isaac-adas/arduino-maze-solving-striker/README.md

<p align="center">

# STRIKER v3










**Wall-following maze robot for Arduino Uno.**

STRIKER holds one wall, takes the turn, and rolls out of the maze on its own. Three ultrasonic sensors, an L298N, and a tab-and-slot plate made for this robot. The plate is **15 × 10 cm**, about half the area of a common 21 × 15 cm chassis. The covers push into the body. Zip ties hold the battery and the driver. No screws and no glue.

<a href="https://youtu.be/cDdMQnneDAg">
  Watch STRIKER solve the maze
</a>

<br>



<br>

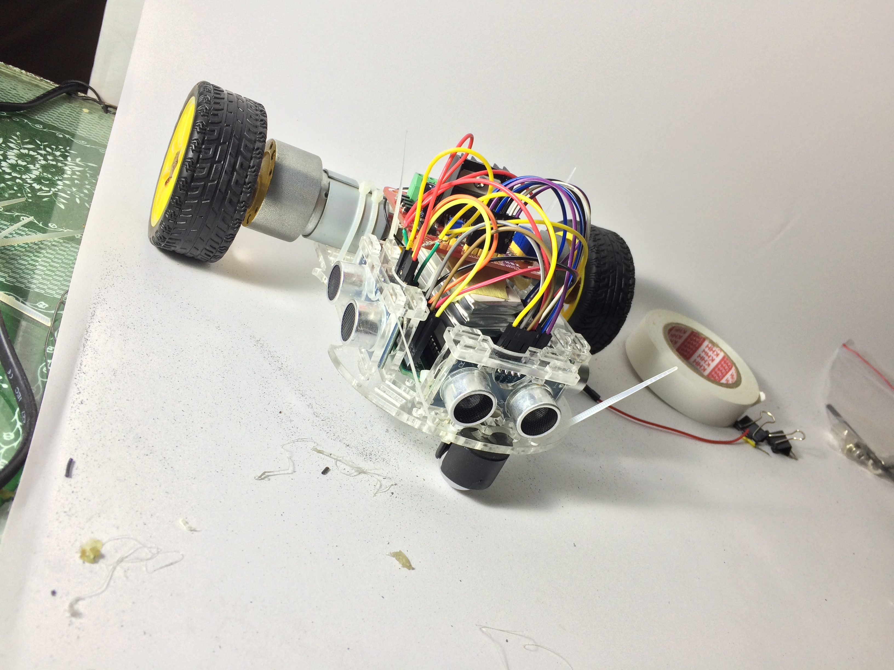
[picture p1: images/finished-robot.jpg]
STRIKER, finished


<br><br>

Build notes: [Maze Solving Robot on Instructables](https://www.instructables.com/Maze-Solving-Robot-MicroMouse-Wall-Following-Robot/)

<br>

[Sketch](#the-sketch) · [Try the wires](#try-the-wires-first) · [Parts](#parts) · [Wiring](#wiring) · [Start](#getting-started) · [Control panel](#control-panel) · [Chassis](#chassis) · [Repo](#repo)

</p>

---

## Repo

```
arduino-maze-solving-striker/
├── Striker_v3/Striker_v3.ino          maze sketch
├── SensorCheck/SensorCheck.ino        distances only, motors off
├── MotorDirection/MotorDirection.ino  one wheel, then the other
├── design/
│   ├── Striker_v3_Chassis.dxf         laser cut, no dimension lines
│   ├── Striker_v3_Chassis.pdf         same cut, for the shop
│   └── Striker_v3_Measures.pdf        dimensions, for reading
├── images/                            photos and the build drawings
├── docs/PIN_LAYOUT.md
├── libraries/NewPing/                 ultrasonic library
├── LICENSE
└── README.md
```

---

## The sketch

One file: [`Striker_v3/Striker_v3.ino`](Striker_v3/Striker_v3.ino).

Set `navigation` in the control panel:

| `navigation` | Steering |
|---|---|
| `SIMPLE_STEER` | Corrects in proportion to the distance error |
| `PID_STEER` | Proportional, integral, and derivative correction |

The sketch ships on `PID_STEER`. Switch to `SIMPLE_STEER` if you want one correction from `steerStrength` instead. Same wires either way.

Every setting you should change is in the **control panel** at the top of the sketch.

---

## Try the wires first

Upload one of these before the maze sketch. Same pins. Wheels off the ground for the motor test.

| Sketch | What you should see |
|---|---|
| [`SensorCheck`](SensorCheck/SensorCheck.ino) | Left, front, and right distances on the Serial Monitor at 115200. Motors stay off. |
| [`MotorDirection`](MotorDirection/MotorDirection.ino) | Left wheel, then right wheel, then both, each for one second. If a wheel goes backward, swap that motor's two wires. Upload nothing after the swap. |

---

## Parts

| Piece | Qty | Notes |
|---|---:|---|
| Arduino UNO | 1 | The brain |
| L298N motor driver | 1 | Wire ENA and ENB. Pull those jumpers only if a motor stays at full speed |
| HC-SR04 ultrasonic sensor | 3 | Left, front, right |
| DC motors + wheels | 2 | |
| 12V battery pack | 1 | Powers the motors through the L298N |
| LEDs + 220–330 Ω resistors | 3 | Optional status lights |
| Chassis, jumpers, zip ties | | See [design/](design/) |

---

## Wiring

The sensors use the analog pins as digital pins, so the PWM pins stay free for the motors.

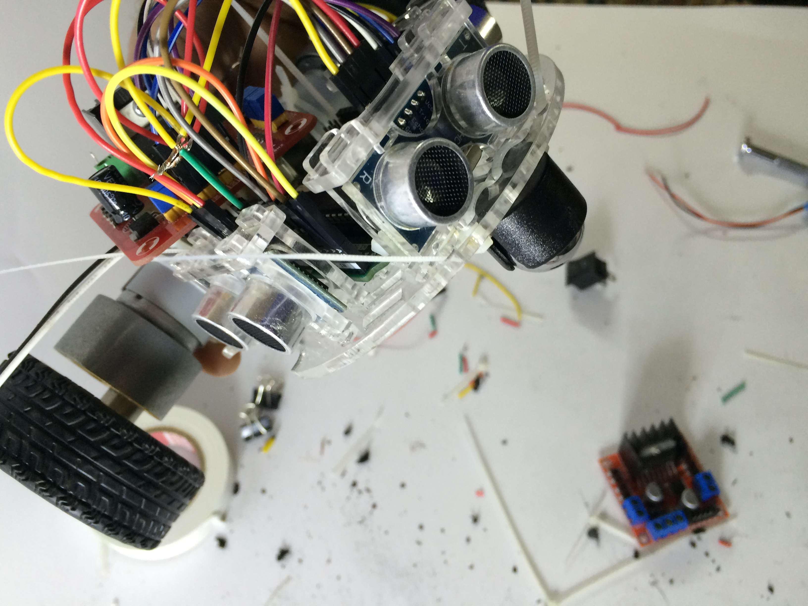
[picture p2: images/sensors-front.jpg]
Sensors on the front edge


```
                 FRONT
        [ L ]    [ F ]    [ R ]
 TRIG     A3       A4       A5
 ECHO     A0       A1       A2
```

| Sensor | TRIG | ECHO |
|---|---|---|
| Left | A3 | A0 |
| Front | A4 | A1 |
| Right | A5 | A2 |

All three sensors: **VCC → 5V**, **GND → GND**.

| L298N | Arduino | Job |
|---|---|---|
| IN1 | D4 | Right motor direction |
| IN2 | D5 | Right motor direction |
| IN3 | D2 | Left motor direction |
| IN4 | D3 | Left motor direction |
| ENA | D11 | Right speed (PWM) |
| ENB | D10 | Left speed (PWM) |

| LED | Pin |
|---|---|
| Status | D13 |
| Following left | D8 |
| Following right | D9 |

> **Power.** Motor current comes from the battery through the L298N, never from an Arduino pin. Tie the Arduino, L298N, sensor, and battery grounds together.

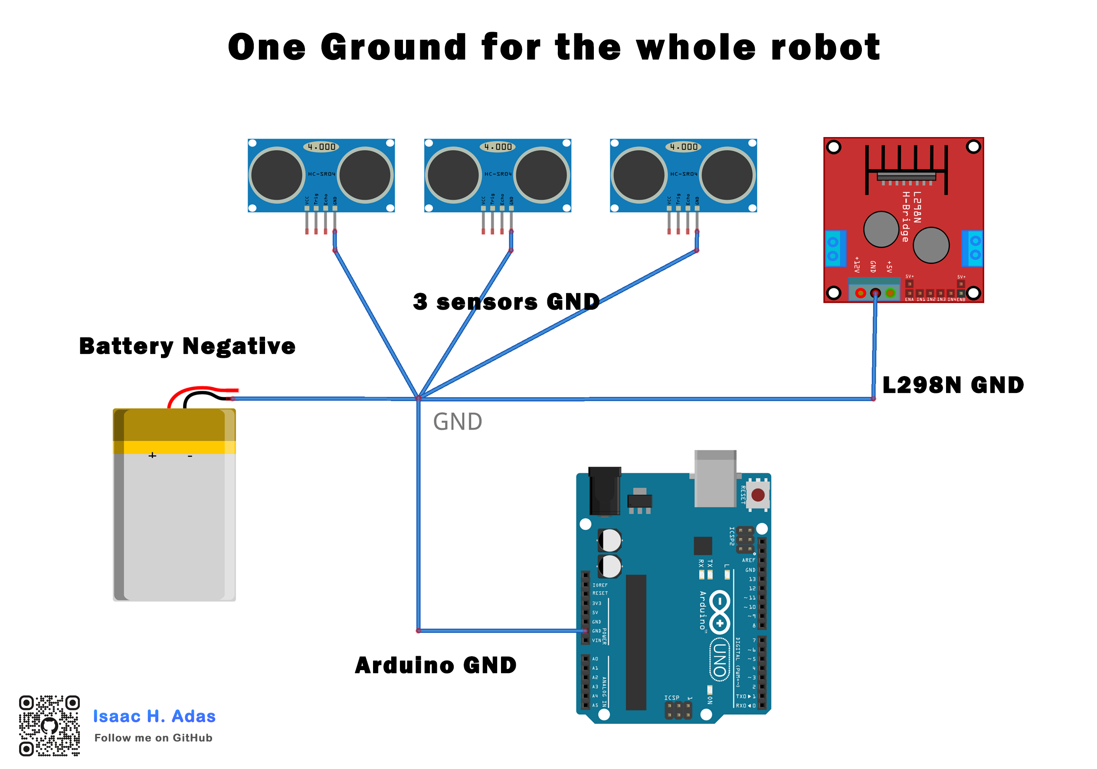
[picture p3: images/common-ground.png]
One ground for the whole robot


Full pin map: [`docs/PIN_LAYOUT.md`](docs/PIN_LAYOUT.md).

---

## Getting started

1. Install the [Arduino IDE](https://www.arduino.cc/en/software).
2. Install **NewPing**. A copy is in [`libraries/NewPing`](libraries/NewPing), or use the IDE Library Manager.
3. Open `Striker_v3`.
4. In the control panel, set `strategy` to `FOLLOW_AUTO`, `FOLLOW_LEFT`, or `FOLLOW_RIGHT`.
5. Leave `runCalibration` set to `false`.
6. Upload, open the Serial Monitor at **115200**, and set the robot in the maze.

Start slow. Raise the speed once it tracks the wall cleanly.

---

## Control panel

Change these at the top of the sketch. The rest of the file is the program.

### Which wall

| Set `strategy` to | What the robot does |
|---|---|
| `FOLLOW_AUTO` | Picks a wall at the first front wall |
| `FOLLOW_LEFT` | Always follows the left wall |
| `FOLLOW_RIGHT` | Always follows the right wall |

On `FOLLOW_AUTO`, the first opening decides. An opening on the left means follow the left wall. An opening on the right means follow the right wall. `autoDefault` is only for `FOLLOW_AUTO`, when both sides are open or both are blocked.

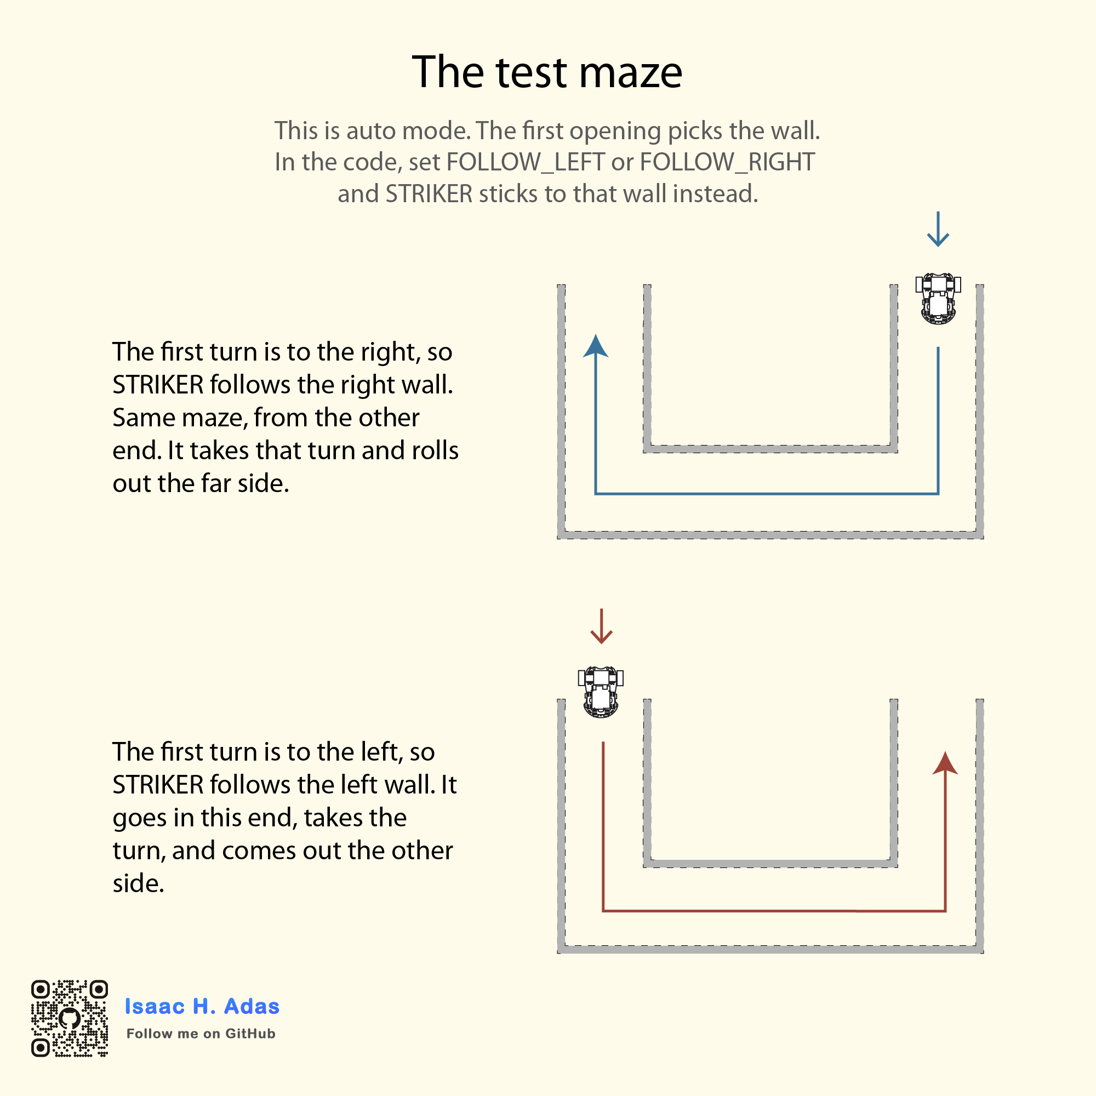
[picture p4: images/test-maze.png]
The test maze


### Passage width

`corridorWidthCm` is one corridor, measured from the left wall to the right wall.

A **30 cm** passage keeps the original distances:

| | Side wall | Front stop | Follow gap |
|---|---:|---:|---:|
| `SIMPLE_STEER` | 13 cm | 8 cm | 10 cm |
| `PID_STEER` | 13 cm | 7 cm | 10 cm |

Change `corridorWidthCm` and those three distances scale with it.

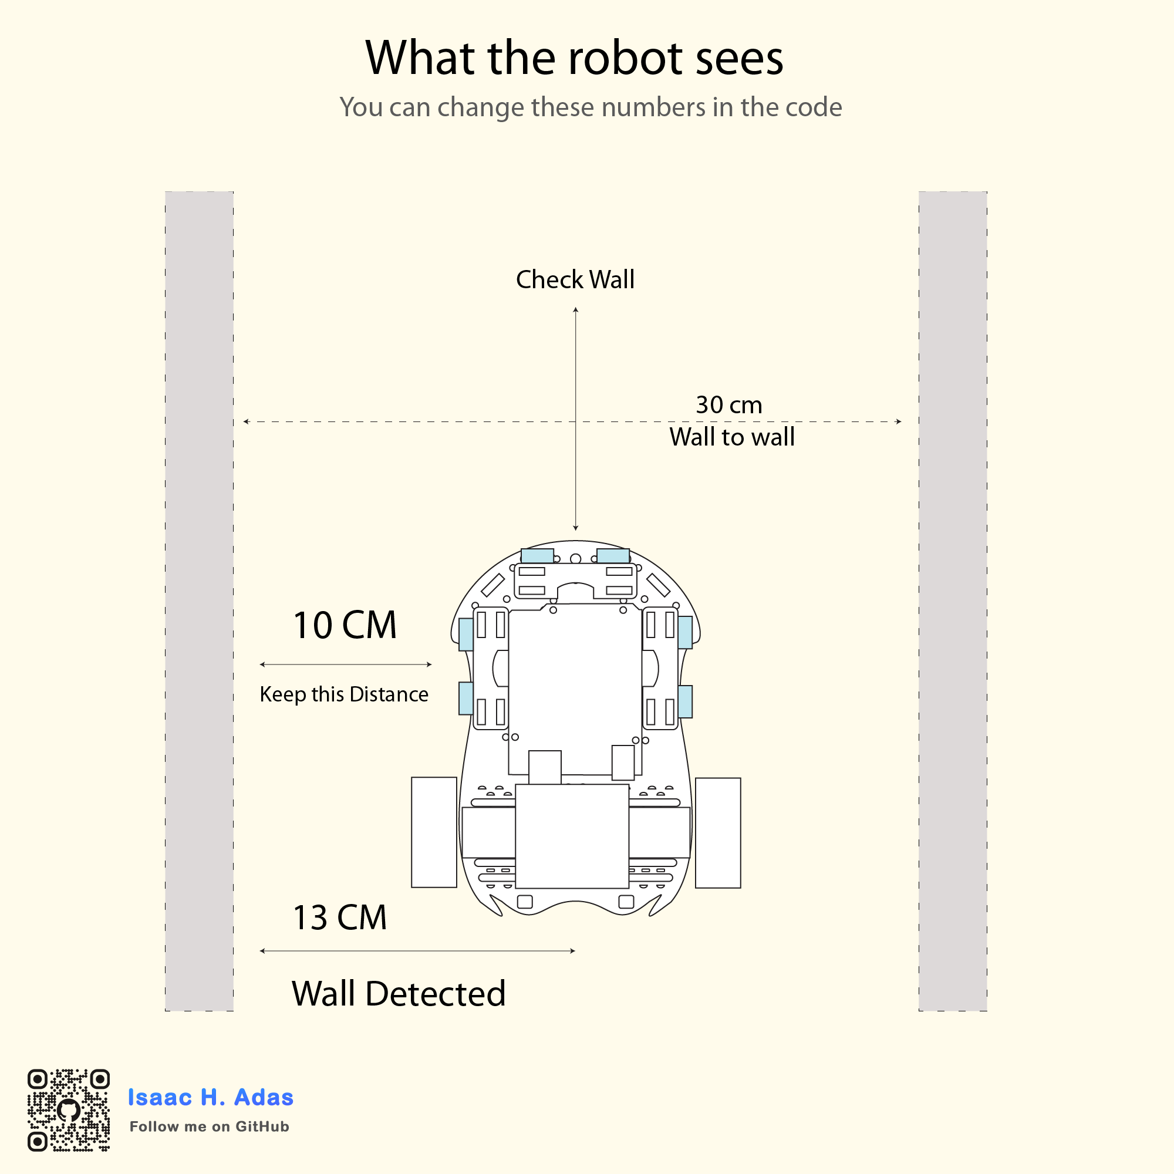
[picture p5: images/what-the-robot-sees.png]
What the robot sees


### Try other distances

1. Set `manualDistances` to `true`.
2. Edit `manualSideWallCm`, `manualFrontStopCm`, and `manualFollowCm`.

### Calibrate

Set `runCalibration` to `true`. The motors stay off.

Open the Serial Monitor at **115200**, put the robot in a passage facing along it, and it will:

1. Collect readings for `calibrationSeconds` (5 by default).
2. Print min, average, and max for each sensor.
3. Print the air gap between the side sensors, and say if that is wider than `corridorWidthCm`.
4. Print three numbers you can copy into the manual distance settings.
5. Keep printing live readings, marked `WALL` or `open`, so you can move the robot and see what the current distances do.

Set `runCalibration` back to `false` before a real run.

### Also in the panel

| Setting | What it changes |
|---|---|
| Speed | How fast it drives and turns |
| `navigation` | `SIMPLE_STEER` or `PID_STEER` |
| `steerStrength` | `SIMPLE_STEER`. How hard it corrects |
| `PID_KP`, `PID_KI`, `PID_KD` | `PID_STEER`. How hard it corrects |

Once the walls end, the robot stops so it does not drive off the stage.

---

## Chassis

The plate is **15 × 10 cm**, in **3 mm** acrylic, laid out on a common **30 × 50 cm** sheet. The cut uses **177 mm** of the 500 mm side. That is **35.4%** of the sheet. The other **323 mm**, **64.6%**, is left for the rest of your cuts. A common 2WD chassis is 21 × 15 cm, which is 315 cm². This plate is 150 cm², about half that area. A 135 × 135 mm plate is 182 cm², and this one is about 18% smaller. The same drawing cuts in plywood. Cardboard works too, and a little glue is fine on cardboard. The slots are sized for a 3 mm sheet. Files and build notes are in [`design/`](design/).

The outline is curved. The earlier plates had sharp edges, and a sharp edge can cut a hand. This one is safer and easier to handle. The file has more than one cover and more than one way to stack the parts. Use the spot where the part fits. The shop file is [`Striker_v3_Chassis.dxf`](design/Striker_v3_Chassis.dxf), and the same cut is [`Striker_v3_Chassis.pdf`](design/Striker_v3_Chassis.pdf). Dimensions are on [`Striker_v3_Measures.pdf`](design/Striker_v3_Measures.pdf). The part on the right of the drawing is the robot. Cut that. The part on the left is optional: the upper deck, the name, and the other pieces on that side.

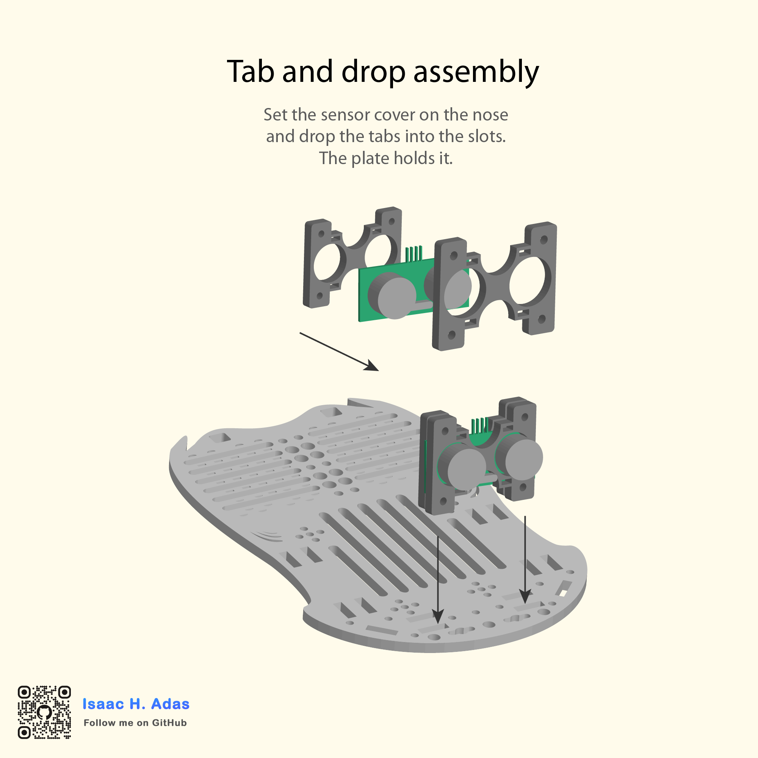
[picture p6: images/tab-and-drop.png]
Tab and drop assembly


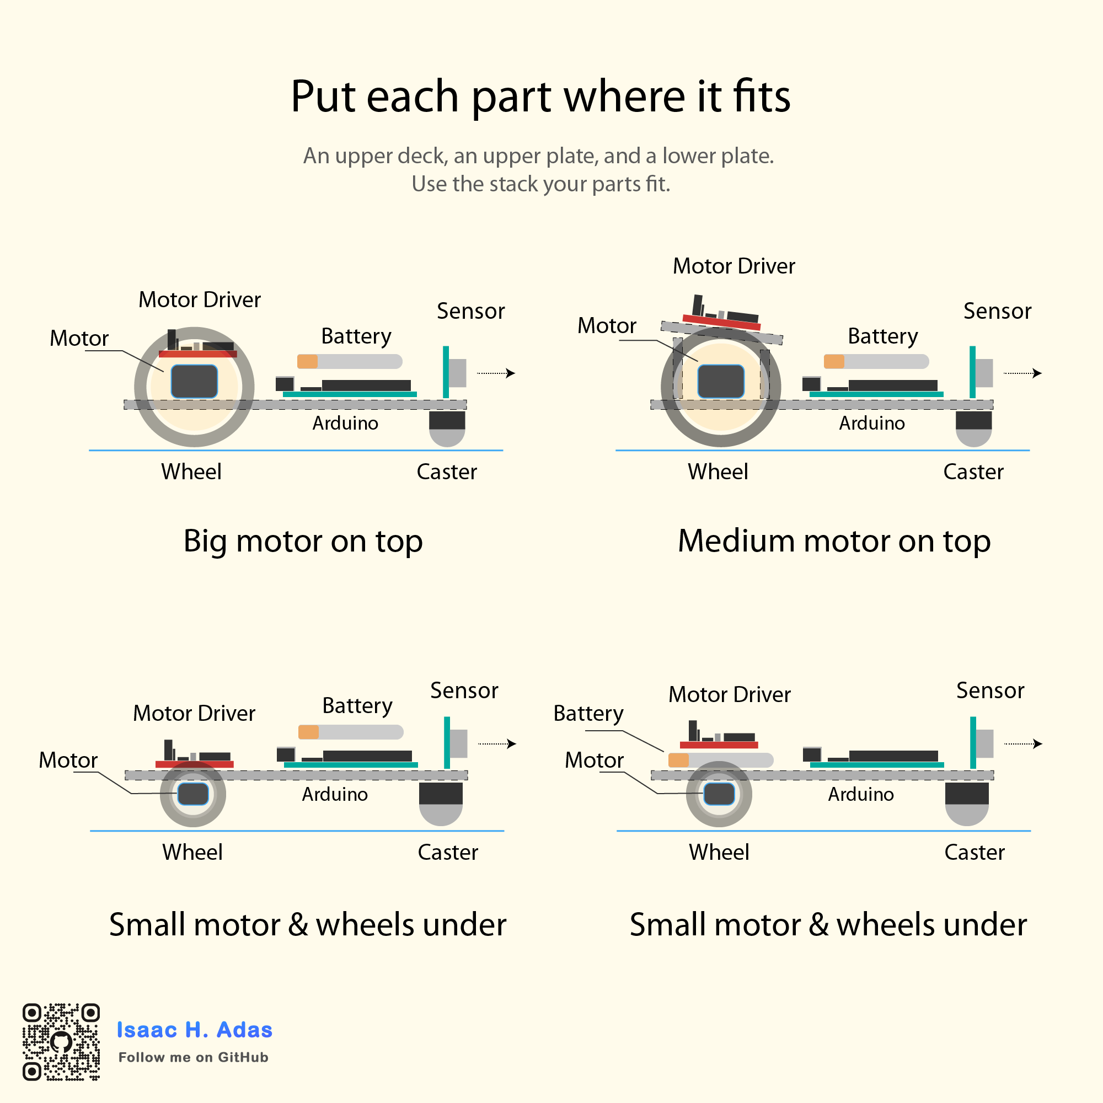
[picture p7: images/parts-fit.png]
Where the parts fit


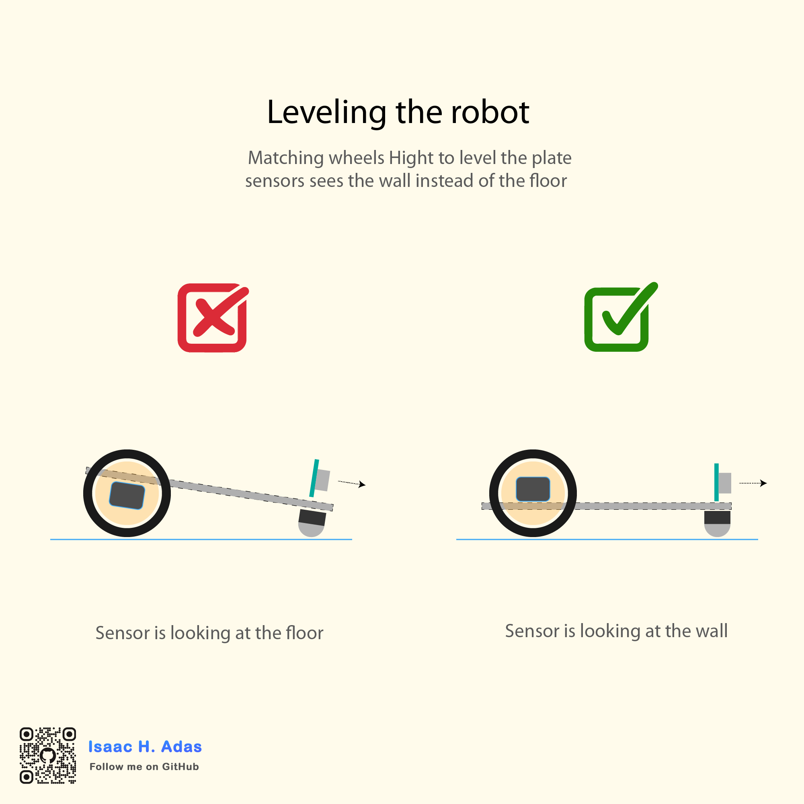
[picture p8: images/leveling.png]
Leveling the robot


A ready-made 2WD chassis works too, as long as the Arduino, driver, and three sensors fit.

The plate is small in the hand. Zip-tie the Arduino at the front only. Leave the back free, so you can lift that end and plug in the USB cable. Tie both ends and you have to take parts off to reach the port.

The back of the plate is tight. A small motor and a small wheel, side by side, is the fit to aim for. The motors in the photos were the ones on hand. They spin faster, and the gearbox plus the wheel is too wide to sit next to its twin, so one motor is mounted ahead of the other. That brings the wide back end in.

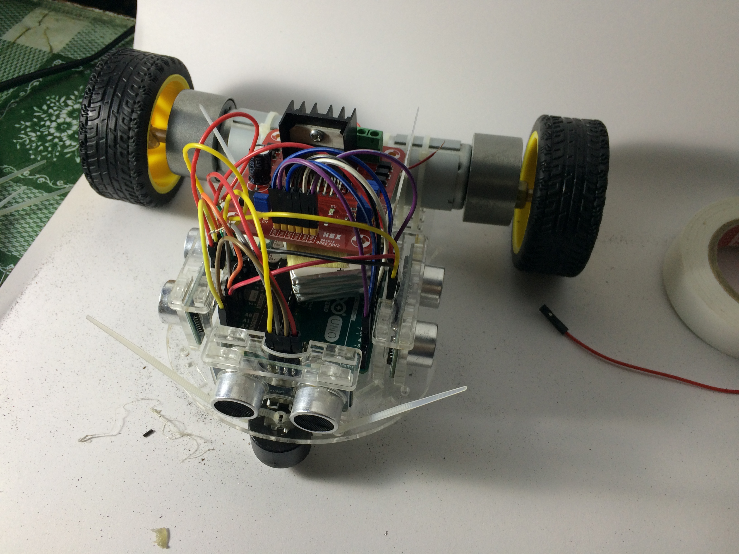
[picture p9: images/plate-top.jpg]
Plate from above


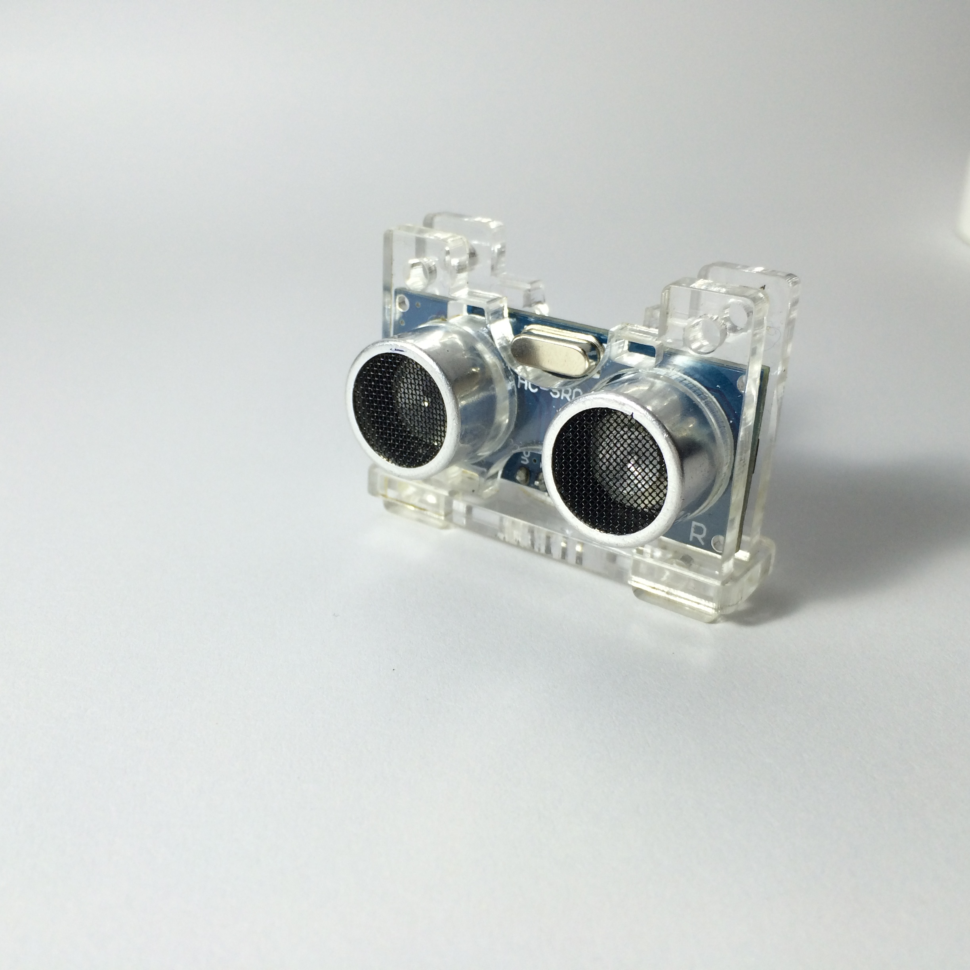
[picture p10: images/tab-and-slot-cover.jpg]
Tab and slot cover


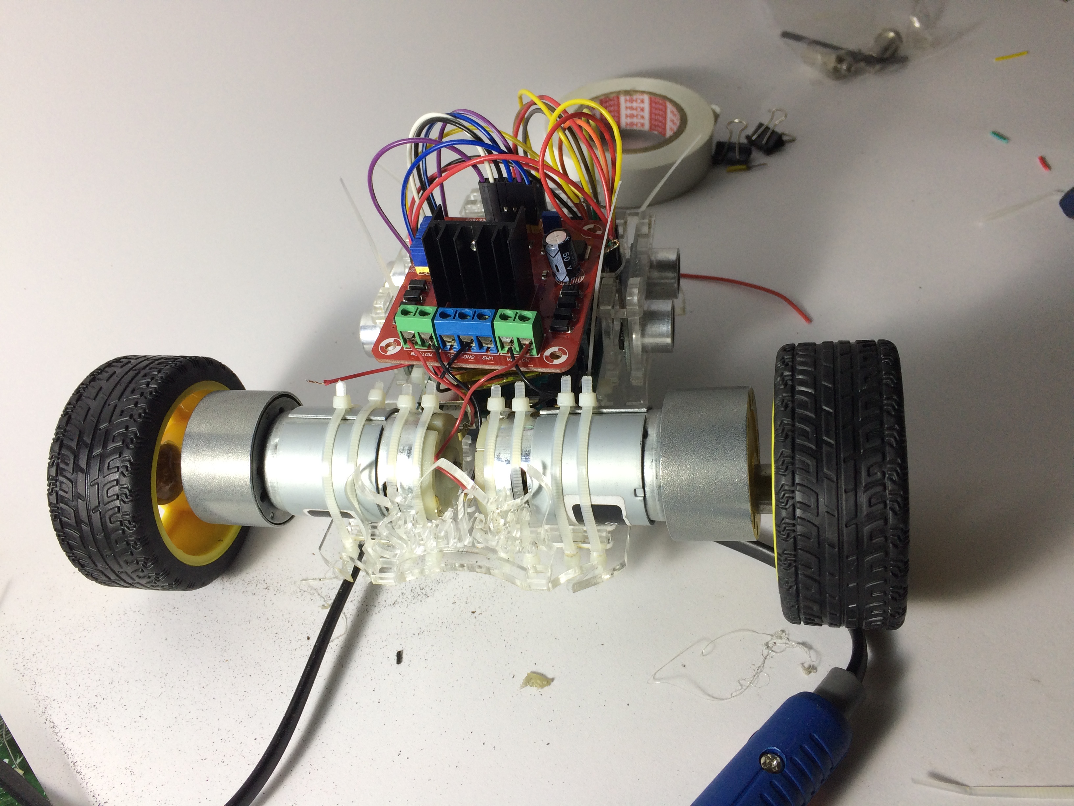
[picture p11: images/stack.jpg]
Motors under the plate, driver on top


---

<p align="center">

MIT. Free to use, modify, and share. See [LICENSE](LICENSE).

</p>
