isaac-adas/arduino-maze-solving-striker/design/Striker_v3_Chassis.dxf

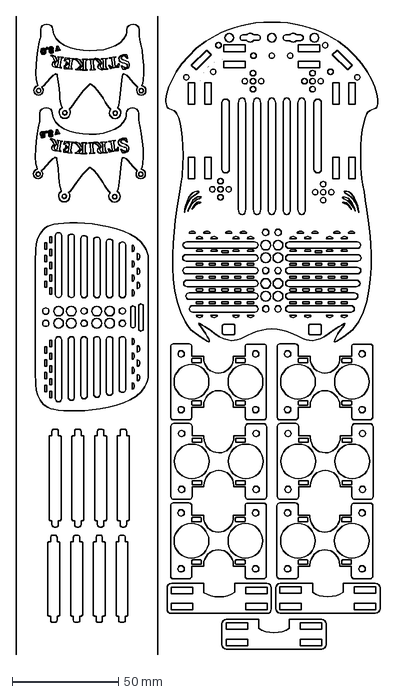
[picture p12: CAD file, 2026-10-31]
design/Striker_v3_Chassis.dxf
174.9 x 300.0 mm
