isaac-adas/arduino-maze-solving-striker/design/Striker_v3_Chassis.pdf

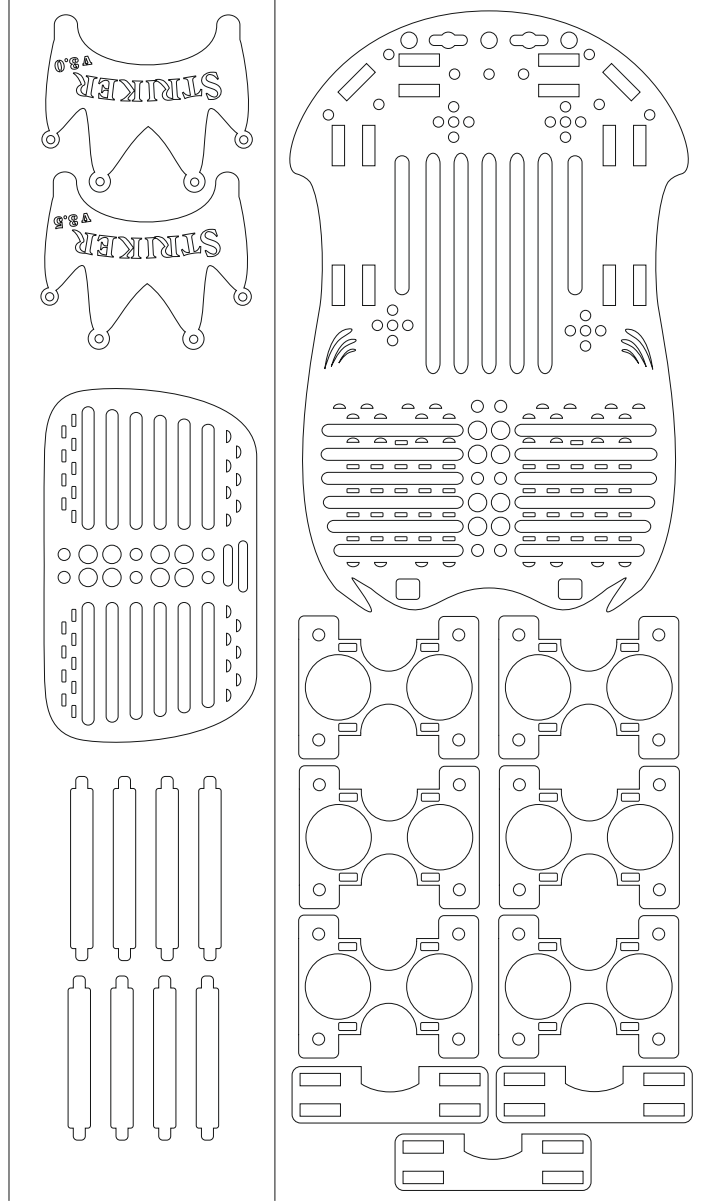
[picture p13: page 1]
