isaac-adas/arduino-maze-solving-striker/design/Striker_v3_Measures.pdf

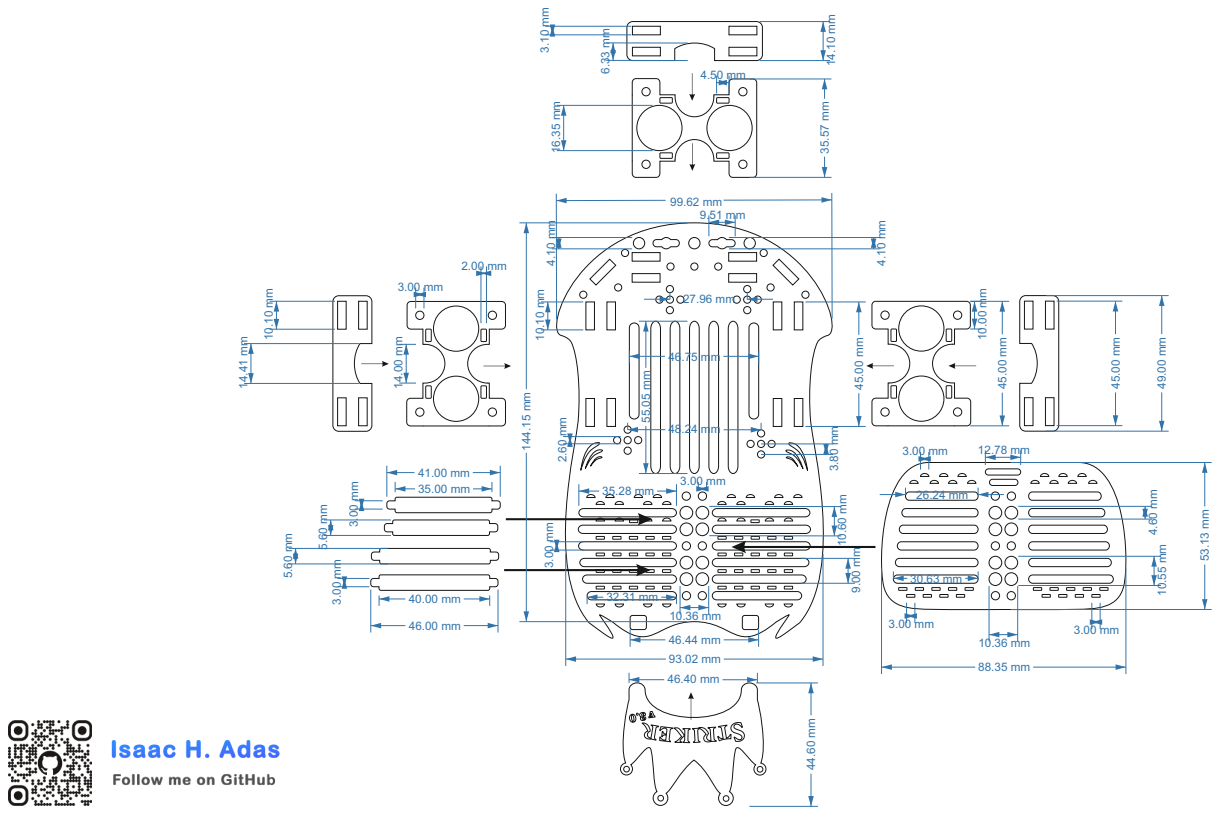
[picture p14: page 1]
