isaac-adas/arduino-maze-solving-striker/(commit log)

2026-10-20 Add STRIKER v3.
    [Striker_v3_Chassis.dxf]
2026-10-20 Name the chassis joint and list the repo tree.
2026-10-21 Space the video link and describe the motor layout.
2026-10-21 Tighten the space around the YouTube link.
2026-10-21 Replace the YouTube heading with a button.
2026-10-21 Note the plate size and the L298N wiring.
2026-10-21 Describe the chassis sheets.
2026-10-22 Present the tab-and-slot plate and the sheets it cuts from.
2026-10-31 Describe the 15 by 10 cm plate.
2026-10-31 Say the curved plate is safer to handle.
2026-10-31 Publish the chassis cut and the build drawings.
    [Striker_v3_Chassis.dxf]
2026-10-31 Say how much of a 30 by 50 cm sheet the cut leaves free.
2026-10-31 Keep only the chassis and measures Illustrator files.
2026-11-03 Say the left side of the cut is optional.
