isaac-adas/arduino-maze-solving-striker/(notices)

Notices in the files:
README.md:
MIT License
